uofu-emb-26/Project_SecurityCamera/docs/img/system_overview.png

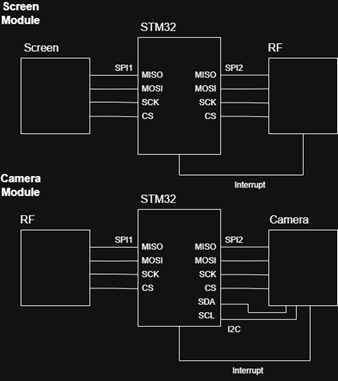
docs/img/system_overview.png
