uofu-emb-26/Project_SecurityCamera/RF/coin.jpeg

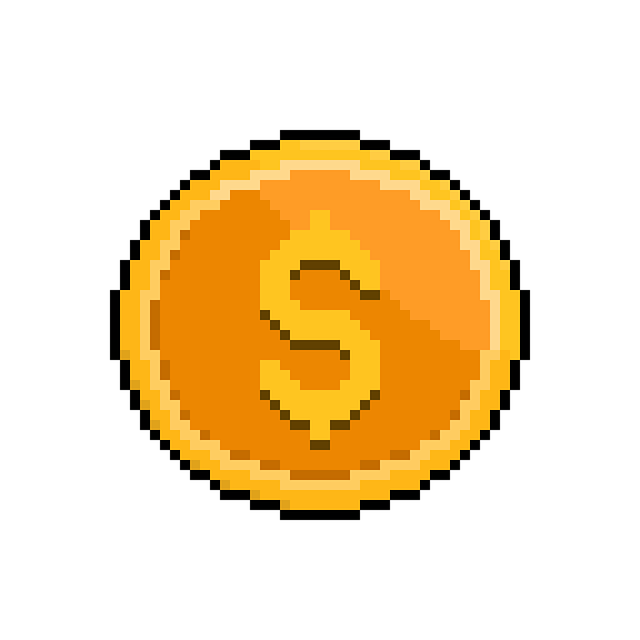
RF/coin.jpeg
