uofu-emb-26/Project_SecurityCamera/camera_screen/captured_frame.h

#ifndef CAPTURED_FRAME_H
#define CAPTURED_FRAME_H

const unsigned int captured_frame_len = 2981;
const unsigned char captured_frame[] = {
    0xFF, 0xD8, 0xFF, 0xE1, 0x01, 0x22, 0x45, 0x78, 0x69, 0x66, 0x00, 0x00, 
    0x49, 0x49, 0x2A, 0x00, 0x08, 0x00, 0x00, 0x00, 0x07, 0x00, 0x0F, 0x01, 
    0x02, 0x00, 0x09, 0x00, 0x00, 0x00, 0x62, 0x00, 0x00, 0x00, 0x10, 0x01, 
    0x02, 0x00, 0x09, 0x00, 0x00, 0x00, 0x6B, 0x00, 0x00, 0x00, 0x1A, 0x01, 
    0x05, 0x00, 0x01, 0x00, 0x00, 0x00, 0x74, 0x00, 0x00, 0x00, 0x1B, 0x01, 
    0x05, 0x00, 0x01, 0x00, 0x00, 0x00, 0x7C, 0x00, 0x00, 0x00, 0x28, 0x01, 
    0x03, 0x00, 0x01, 0x00, 0x00, 0x00, 0x02, 0x00, 0x00, 0x00, 0x13, 0x02, 
    0x03, 0x00, 0x01, 0x00, 0x00, 0x00, 0x02, 0x00, 0x00, 0x00, 0x69, 0x87, 
    0x04, 0x00, 0x01, 0x00, 0x00, 0x00, 0x84, 0x00, 0x00, 0x00, 0x00, 0x00, 
    0x00, 0x00, 0x00, 0x00, 0x00, 0x00, 0x00, 0x00, 0x00, 0x00, 0x00, 0x00, 
    0x00, 0x00, 0x00, 0x00, 0x00, 0x00, 0x00, 0x00, 0x20, 0x01, 0x00, 0x00, 
    0x01, 0x00, 0x00, 0x00, 0x20, 0x01, 0x00, 0x00, 0x01, 0x00, 0x00, 0x00, 
    0x0A, 0x00, 0x9A, 0x82, 0x05, 0x00, 0x01, 0x00, 0x00, 0x00, 0x02, 0x01, 
    0x00, 0x00, 0x27, 0x88, 0x03, 0x00, 0x01, 0x00, 0x00, 0x00, 0x00, 0x00, 
    0x00, 0x00, 0x00, 0x90, 0x07, 0x00, 0x04, 0x00, 0x00, 0x00, 0x30, 0x32, 
    0x32, 0x32, 0x01, 0x91, 0x07, 0x00, 0x04, 0x00, 0x00, 0x00, 0x01, 0x02, 
    0x03, 0x00, 0x01, 0x92, 0x0A, 0x00, 0x01, 0x00, 0x00, 0x00, 0x0A, 0x01, 
    0x00, 0x00, 0x02, 0x92, 0x05, 0x00, 0x01, 0x00, 0x00, 0x00, 0x12, 0x01, 
    0x00, 0x00, 0x00, 0xA0, 0x07, 0x00, 0x04, 0x00, 0x00, 0x00, 0x00, 0x00, 
    0x00, 0x00, 0x01, 0xA0, 0x03, 0x00, 0x01, 0x00, 0x00, 0x00, 0x01, 0x00, 
    0x00, 0x00, 0x02, 0xA0, 0x04, 0x00, 0x01, 0x00, 0x00, 0x00, 0xA0, 0x00, 
    0x00, 0x00, 0x03, 0xA0, 0x04, 0x00, 0x01, 0x00, 0x00, 0x00, 0x78, 0x00, 
    0x00, 0x00, 0x00, 0x00, 0x00, 0x00, 0x01, 0x00, 0x00, 0x00, 0x0F, 0x00, 
    0x00, 0x00, 0x04, 0x00, 0x00, 0x00, 0x01, 0x00, 0x00, 0x00, 0x00, 0x00, 
    0x00, 0x00, 0x00, 0x00, 0x00, 0x00, 0xFF, 0xDB, 0x00, 0x84, 0x00, 0x10, 
    0x0B, 0x0C, 0x0E, 0x0C, 0x0A, 0x10, 0x0E, 0x0D, 0x0E, 0x11, 0x10, 0x10, 
    0x12, 0x17, 0x27, 0x19, 0x17, 0x15, 0x15, 0x17, 0x30, 0x22, 0x24, 0x1C, 
    0x27, 0x39, 0x32, 0x3C, 0x3B, 0x38, 0x32, 0x37, 0x36, 0x3F, 0x47, 0x5A, 
    0x4D, 0x3F, 0x43, 0x55, 0x44, 0x36, 0x37, 0x4F, 0x6B, 0x4F, 0x55, 0x5D, 
    0x60, 0x65, 0x66, 0x65, 0x3D, 0x4C, 0x6F, 0x77, 0x6E, 0x62, 0x76, 0x5A, 
    0x63, 0x65, 0x61, 0x01, 0x10, 0x11, 0x11, 0x17, 0x14, 0x17, 0x2E, 0x19, 
    0x19, 0x2E, 0x61, 0x41, 0x37, 0x41, 0x61, 0x61, 0x61, 0x61, 0x61, 0x61, 
    0x61, 0x61, 0x61, 0x61, 0x61, 0x61, 0x61, 0x61, 0x61, 0x61, 0x61, 0x61, 
    0x61, 0x61, 0x61, 0x61, 0x61, 0x61, 0x61, 0x61, 0x61, 0x61, 0x61, 0x61, 
    0x61, 0x61, 0x61, 0x61, 0x61, 0x61, 0x61, 0x61, 0x61, 0x61, 0x61, 0x61, 
    0x61, 0x61, 0x61, 0x61, 0x61, 0x61, 0x61, 0x61, 0xFF, 0xDD, 0x00, 0x04, 
    0x00, 0xC8, 0xFF, 0xC0, 0x00, 0x11, 0x08, 0x00, 0x78, 0x00, 0xA0, 0x03, 
    0x01, 0x21, 0x00, 0x02, 0x11, 0x01, 0x03, 0x11, 0x01, 0xFF, 0xC4, 0x01, 
    0xA2, 0x00, 0x00, 0x01, 0x05, 0x01, 0x01, 0x01, 0x01, 0x01, 0x01, 0x00, 
    0x00, 0x00, 0x00, 0x00, 0x00, 0x00, 0x00, 0x01, 0x02, 0x03, 0x04, 0x05, 
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
};

#endif
