uofu-emb-26/Project_SecurityCamera/main_base_station/Src/ili9341_font.c

// MIT License
//
// Copyright (c) 2020 ardnew
//
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
// Source: https://github.com/ardnew/ILI9341-STM32-HAL/tree/master

// ----------------------------------------------------------------- includes --

#include "ili9341_font.h"

// ---------------------------------------------------------- private defines --

#define __ILI9341_FONT_FIRST_GLYPH__ ' ' // ASCII 0x20 space
#define __ILI9341_FONT_LAST_GLYPH__  '~' // ASCII 0x7E tilde

// ----------------------------------------------------------- private macros --

/* nothing */

// ----------------------------------------------------------- private types --

/* nothing */

// ------------------------------------------------------- exported variables --

ili9341_font_t const ili9341_font_7x10 = {
  .width  = 7,
  .height = 10,
  .glyph  = {
    0x0000, 0x0000, 0x0000, 0x0000, 0x0000, 0x0000, 0x0000, 0x0000, 0x0000, 0x0000,  // sp
    0x1000, 0x1000, 0x1000, 0x1000, 0x1000, 0x1000, 0x0000, 0x1000, 0x0000, 0x0000,  // !
    0x2800, 0x2800, 0x2800, 0x0000, 0x0000, 0x0000, 0x0000, 0x0000, 0x0000, 0x0000,  // "
    0x2400, 0x2400, 0x7C00, 0x2400, 0x4800, 0x7C00, 0x4800, 0x4800, 0x0000, 0x0000,  // #
    0x3800, 0x5400, 0x5000, 0x3800, 0x1400, 0x5400, 0x5400, 0x3800, 0x1000, 0x0000,  // $
    0x2000, 0x5400, 0x5800, 0x3000, 0x2800, 0x5400, 0x1400, 0x0800, 0x0000, 0x0000,  // %
    0x1000, 0x2800, 0x2800, 0x1000, 0x3400, 0x4800, 0x4800, 0x3400, 0x0000, 0x0000,  // &
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
  }
};

// ------------------------------------------------------- private variables --

/* nothing */

// ------------------------------------------------------ function prototypes --

/* nothing */

// ------------------------------------------------------- exported functions --

uint8_t glyph_index(unsigned char glyph)
{
  if ((glyph >= __ILI9341_FONT_FIRST_GLYPH__) &&
      (glyph <= __ILI9341_FONT_LAST_GLYPH__)) {
    return glyph - __ILI9341_FONT_FIRST_GLYPH__;
  }
  return 0; // on error, return index of ASCII space (0x20)
}

// ------------------------------------------------------- private functions --

/* nothing */
