uofu-emb-26/Project_SecurityCamera/main_base_station/Src/images.c

#include "images.h"

// RGB565 has form RRRR:RGGG_GGGB:BBBB
// This array has been endian swapped to GGGB:BBBB_RRRR:RGGG
// for transmission to the screen (since the STM32F072 is little-endian and the screen is big-endian)
const uint16_t red_16x16[256] = {
    0x00F8, 0x00F8, 0x00F8, 0x00F8, 0x00F8, 0x00F8, 0x00F8, 0x00F8, 0x00F8, 0x00F8, 0x00F8, 0x00F8, 0x00F8, 0x00F8, 0x00F8, 0x00F8,
    0x00F8, 0x00F8, 0x00F8, 0x00F8, 0x00F8, 0x00F8, 0x00F8, 0x00F8, 0x00F8, 0x00F8, 0x00F8, 0x00F8, 0x00F8, 0x00F8, 0x00F8, 0x00F8,
    0x00F8, 0x00F8, 0x00F8, 0x00F8, 0x00F8, 0x00F8, 0x00F8, 0x00F8, 0x00F8, 0x00F8, 0x00F8, 0x00F8, 0x00F8, 0x00F8, 0x00F8, 0x00F8,
    0x00F8, 0x00F8, 0x00F8, 0x00F8, 0x00F8, 0x00F8, 0x00F8, 0x00F8, 0x00F8, 0x00F8, 0x00F8, 0x00F8, 0x00F8, 0x00F8, 0x00F8, 0x00F8,
    0x00F8, 0x00F8, 0x00F8, 0x00F8, 0x00F8, 0x00F8, 0x00F8, 0x00F8, 0x00F8, 0x00F8, 0x00F8, 0x00F8, 0x00F8, 0x00F8, 0x00F8, 0x00F8,
    0x00F8, 0x00F8, 0x00F8, 0x00F8, 0x00F8, 0x00F8, 0x00F8, 0x00F8, 0x00F8, 0x00F8, 0x00F8, 0x00F8, 0x00F8, 0x00F8, 0x00F8, 0x00F8,
    0x00F8, 0x00F8, 0x00F8, 0x00F8, 0x00F8, 0x00F8, 0x00F8, 0x00F8, 0x00F8, 0x00F8, 0x00F8, 0x00F8, 0x00F8, 0x00F8, 0x00F8, 0x00F8,
    0x00F8, 0x00F8, 0x00F8, 0x00F8, 0x00F8, 0x00F8, 0x00F8, 0x00F8, 0x00F8, 0x00F8, 0x00F8, 0x00F8, 0x00F8, 0x00F8, 0x00F8, 0x00F8,
    0x00F8, 0x00F8, 0x00F8, 0x00F8, 0x00F8, 0x00F8, 0x00F8, 0x00F8, 0x00F8, 0x00F8, 0x00F8, 0x00F8, 0x00F8, 0x00F8, 0x00F8, 0x00F8,
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
	0xA7, 0x7A, 0x45, 0x6A, 0xA9, 0xA3, 0x46, 0x6A, 0xA7, 0x72, 0xCA, 0xAB,
	0x89, 0xA3, 0x89, 0x9B, 0x49, 0x93, 0xA7, 0x7A, 0x45, 0x6A, 0xCA, 0xAB,
	0xC7, 0x7A, 0x05, 0x5A, 0xA7, 0x72, 0x46, 0x6A, 0xCA, 0xAB, 0xEA, 0xAB,
	0xE8, 0x82, 0x28, 0x8B, 0xC7, 0x7A, 0xE7, 0x82, 0x48, 0x93, 0x48, 0x93,
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
};

/**
 * @brief Performs an in-place 2-byte endian swap on an array of 16-bit pixel data.
 * @note For this function to work, buffer16 must be stored in RAM (it must not be a const)
 * @param buffer16 Pointer to the 16-bit pixel buffer to be swapped. 
 * @param num_pixels The total number of 16-bit pixels in the buffer.
 */
void ili9341_array_endian_swap(uint16_t *buffer16, uint32_t num_pixels)
{
    uint32_t *buffer32 = (uint32_t *)buffer16;

    // Perform the endian swap on every two pixels
    for (uint32_t i = 0; i < (num_pixels / 2); i++)
    {
        // Flips A, B, C, D to B, A, D, C (endian-swap on 2-byte values)
		// This is a hardware instruction, so this performs the endian-swap
		// as quickly as possible
        buffer32[i] = __REV16(buffer32[i]);
    }

    // Endian-swap on the final pixel, if needed
    if ((num_pixels % 2) != 0)
    {
        buffer16[num_pixels - 1] = __REV16(buffer16[num_pixels - 1]);
    }
}
