uofu-emb-26/Project_SecurityCamera/camera_screen/Src/spi.c

#include "spi.h"
#include "main.h"
#include "stm32f0xx_hal.h"

SPI_HandleTypeDef hspi1;
SPI_HandleTypeDef hspi2;
DMA_HandleTypeDef hdma_spi1_tx;

/* ===================== SPI2 : CAMERA ===================== */

void SPI2_Init(void)
{
    __HAL_RCC_SPI2_CLK_ENABLE();
    __HAL_RCC_GPIOB_CLK_ENABLE();

    GPIO_InitTypeDef GPIO_InitStruct = {0};
    GPIO_InitStruct.Pin = GPIO_PIN_13 | GPIO_PIN_14 | GPIO_PIN_15;
    GPIO_InitStruct.Mode = GPIO_MODE_AF_PP;
    GPIO_InitStruct.Pull = GPIO_NOPULL;
    GPIO_InitStruct.Speed = GPIO_SPEED_FREQ_HIGH;
    GPIO_InitStruct.Alternate = GPIO_AF0_SPI2;
    HAL_GPIO_Init(GPIOB, &GPIO_InitStruct);

    hspi2.Instance = SPI2;
    hspi2.Init.Mode = SPI_MODE_MASTER;
    hspi2.Init.Direction = SPI_DIRECTION_2LINES;
    hspi2.Init.DataSize = SPI_DATASIZE_8BIT;
    hspi2.Init.CLKPolarity = SPI_POLARITY_LOW;
    hspi2.Init.CLKPhase = SPI_PHASE_1EDGE;
    hspi2.Init.NSS = SPI_NSS_SOFT;
    hspi2.Init.BaudRatePrescaler = SPI_BAUDRATEPRESCALER_32;
    hspi2.Init.FirstBit = SPI_FIRSTBIT_MSB;
    hspi2.Init.TIMode = SPI_TIMODE_DISABLE;
    hspi2.Init.CRCCalculation = SPI_CRCCALCULATION_DISABLE;
    hspi2.Init.CRCPolynomial = 7;
    hspi2.Init.CRCLength = SPI_CRC_LENGTH_DATASIZE;
    hspi2.Init.NSSPMode = SPI_NSS_PULSE_ENABLE;

    HAL_SPI_Init(&hspi2);
}

uint8_t SPI2_ReadWriteByte(uint8_t TxData)
{
    uint8_t RxData = 0;
    HAL_SPI_TransmitReceive(&hspi2, &TxData, &RxData, 1, 100);
    return RxData;
}

void SPI2_WriteBuffer(uint8_t *data, uint32_t len)
{
    HAL_SPI_Transmit(&hspi2, data, len, HAL_MAX_DELAY);
}

/* ===================== SPI1 : SCREEN ===================== */

void SPI1_DMA_Init(void)
{
    __HAL_RCC_DMA1_CLK_ENABLE();

    HAL_NVIC_SetPriority(DMA1_Channel2_3_IRQn, 0, 0);
    HAL_NVIC_EnableIRQ(DMA1_Channel2_3_IRQn);
}

void SPI1_GPIO_Init(void)
{
    GPIO_InitTypeDef GPIO_InitStruct = {0};

    __HAL_RCC_GPIOA_CLK_ENABLE();
    __HAL_RCC_GPIOB_CLK_ENABLE();

    /* TFT control pins on GPIOA */
    HAL_GPIO_WritePin(GPIOA, TFT_CS_Pin | TFT_DC_Pin | TFT_RST_Pin, GPIO_PIN_SET);

    GPIO_InitStruct.Pin = TFT_DC_Pin;
    GPIO_InitStruct.Mode = GPIO_MODE_OUTPUT_PP;
    GPIO_InitStruct.Pull = GPIO_NOPULL;
    GPIO_InitStruct.Speed = GPIO_SPEED_FREQ_HIGH;
    HAL_GPIO_Init(TFT_DC_GPIO_Port, &GPIO_InitStruct);

    GPIO_InitStruct.Pin = TFT_CS_Pin;
    GPIO_InitStruct.Mode = GPIO_MODE_OUTPUT_OD;
    GPIO_InitStruct.Pull = GPIO_NOPULL;
    GPIO_InitStruct.Speed = GPIO_SPEED_FREQ_HIGH;
    HAL_GPIO_Init(TFT_CS_GPIO_Port, &GPIO_InitStruct);

    GPIO_InitStruct.Pin = TFT_RST_Pin;
    GPIO_InitStruct.Mode = GPIO_MODE_OUTPUT_OD;
    GPIO_InitStruct.Pull = GPIO_PULLUP;
    GPIO_InitStruct.Speed = GPIO_SPEED_FREQ_LOW;
    HAL_GPIO_Init(TFT_RST_GPIO_Port, &GPIO_InitStruct);

    /* SPI1 pins on GPIOB: PB3=SCK, PB4=MISO, PB5=MOSI */
    GPIO_InitStruct.Pin = GPIO_PIN_3 | GPIO_PIN_4 | GPIO_PIN_5;
    GPIO_InitStruct.Mode = GPIO_MODE_AF_PP;
    GPIO_InitStruct.Pull = GPIO_NOPULL;
    GPIO_InitStruct.Speed = GPIO_SPEED_FREQ_HIGH;
    GPIO_InitStruct.Alternate = GPIO_AF0_SPI1;
    HAL_GPIO_Init(GPIOB, &GPIO_InitStruct);
}

void SPI1_Init(void)
{
    __HAL_RCC_SPI1_CLK_ENABLE();

    hspi1.Instance = SPI1;
    hspi1.Init.Mode = SPI_MODE_MASTER;
    hspi1.Init.Direction = SPI_DIRECTION_2LINES;
    hspi1.Init.DataSize = SPI_DATASIZE_8BIT;
    hspi1.Init.CLKPolarity = SPI_POLARITY_LOW;
    hspi1.Init.CLKPhase = SPI_PHASE_1EDGE;
    hspi1.Init.NSS = SPI_NSS_SOFT;
    hspi1.Init.BaudRatePrescaler = SPI_BAUDRATEPRESCALER_4;
    hspi1.Init.FirstBit = SPI_FIRSTBIT_MSB;
    hspi1.Init.TIMode = SPI_TIMODE_DISABLE;
    hspi1.Init.CRCCalculation = SPI_CRCCALCULATION_DISABLE;
    hspi1.Init.CRCPolynomial = 7;
    hspi1.Init.CRCLength = SPI_CRC_LENGTH_DATASIZE;
    hspi1.Init.NSSPMode = SPI_NSS_PULSE_ENABLE;

    HAL_SPI_Init(&hspi1);
}

void SPI1_WriteBuffer(uint8_t *data, uint32_t len)
{
    HAL_SPI_Transmit(&hspi1, data, len, HAL_MAX_DELAY);
}
