uofu-emb-26/Project_SecurityCamera/main_base_station/Inc/ili9341_ext.h

// Created by Zachary Ward to extend the ILI9341 TFT driver to write raw buffer
// data using DMA.

#ifndef __ILI9341_EXT_H
#define __ILI9341_EXT_H

#include <stdint.h>
#include "ili9341.h"
#include "ili9341_gfx.h"
#include "images.h"

// The display uses RGB565 (with 16 color bits per pixel)
#define BYTES_PER_PIXEL 2

#ifdef __cplusplus
extern "C" {
#endif

void ili9341_draw_buffer(ili9341_t *lcd, int16_t x, int16_t y, int16_t w, int16_t h, uint16_t *buffer, uint8_t endian_swap);
void ili9341_draw_region(ili9341_t *lcd, uint8_t column, uint8_t row, uint16_t *buffer, uint8_t endian_swap);

#ifdef __cplusplus
}
#endif

#endif /* __ILI9341_EXT_H */
