uofu-emb-26/Project_SecurityCamera/(commit log)

2026-03-17 Restructure repo into separate folders, removed labs from CMAKE and added new folders, add ArduCAM HAL driver files.
2026-03-21 Extended ILI9341 library to draw a buffer to the screen using DMA
2026-03-21 Initialized SPI, DMA, and GPIO peripherals (code autogenerated by STM32CubeMx)
2026-03-21 Added camera.c, and camera.h. Split the debug and main into two builds. Functionality for reading JPEG data using I2C/SPI.
2026-03-21 Added notes on which pins can be used for SPI and I2C
2026-03-21 Updated display connections to those usable on the Discovery board
2026-03-21 Fixed ILI9341 library for when no touchscreen is connected
    [ili9341.c]
2026-03-22 Fixed type sizes in ILI9341 library
    [ili9341_gfx.c, ili9341_gfx.h]
2026-03-22 Added wiring diagram for screen
2026-03-26 add nrf24l01p driver and verify spi communication
2026-04-01 Add NRF24L01+ SPI loopback test with LED status indicators
2026-04-01 Added python script in camera folder.
2026-04-08 Added functionality for SPI read out of JPEG data. Adder timer/interupt functionality to camera/main. Added ability to individual camera data using camera/main_uart_debug.
2026-04-15 Created project for the Camera Module; merged code for camera and RF chips (moved RF TX to SPI1)
2026-04-16 Added Camera Module code to synchronize frame capture with RF transmission
2026-04-16 fixed wrong named variables
    [main.c]
2026-04-16 Add TX/RX image transmission code by using two STM boards
2026-04-16 Added camera_screen files to flash camera data on screen.
2026-04-16 Added working camera/TJpegDec decoder code
2026-04-16 made 'rect' a member of JDEC structure as a global variable and inserted wait statement for SPI
2026-04-16 Notes on needed pin remappings (final pin layout)
2026-04-19 Integrated RF+Camera projects for main_camera_module and RF+camera_screen projects for main_base_station; added sychronization and buffers for each
2026-04-19 Added RF transmit failure logic and LED error indicators
    [jpeg_decode.c, main.c, main.h]
2026-04-19 Fixed interrupt priorities
2026-04-19 Remapped pins in both main modules to prevent conflicts on the STM32F072 Discovery Board
    [main.c]
2026-04-19 Fixed Base Station RF pins
    [main.c]
2026-04-21 Troubleshooting communication with camera
2026-04-22 (working) Replaced camera with static image; converted all interrupts to polling; converted DMA to blocking
    [main.c, test_frame.h]
2026-04-22 (working) Reverted Base Station code to fancy version
    [main.c]
2026-04-22 (working) Replaced Camera Module with fancy version (without camera)
    [main.c]
2026-04-22 (working) reverted pins to system diagram
    [ArduCAM.c, ArduCAM.h, main.c]
2026-04-22 Remove USB-UART Bridge details from README
    Removed RX STM32 ↔ USB-UART Bridge section from README.
2026-04-24 Added final wiring diagram
2026-04-24 Added data flow documentation
2026-04-28 Added camera description to README. Added camera and base station images to overview in README.
