uofu-emb-26/Project_SecurityCamera/docs/img/system_connections.png

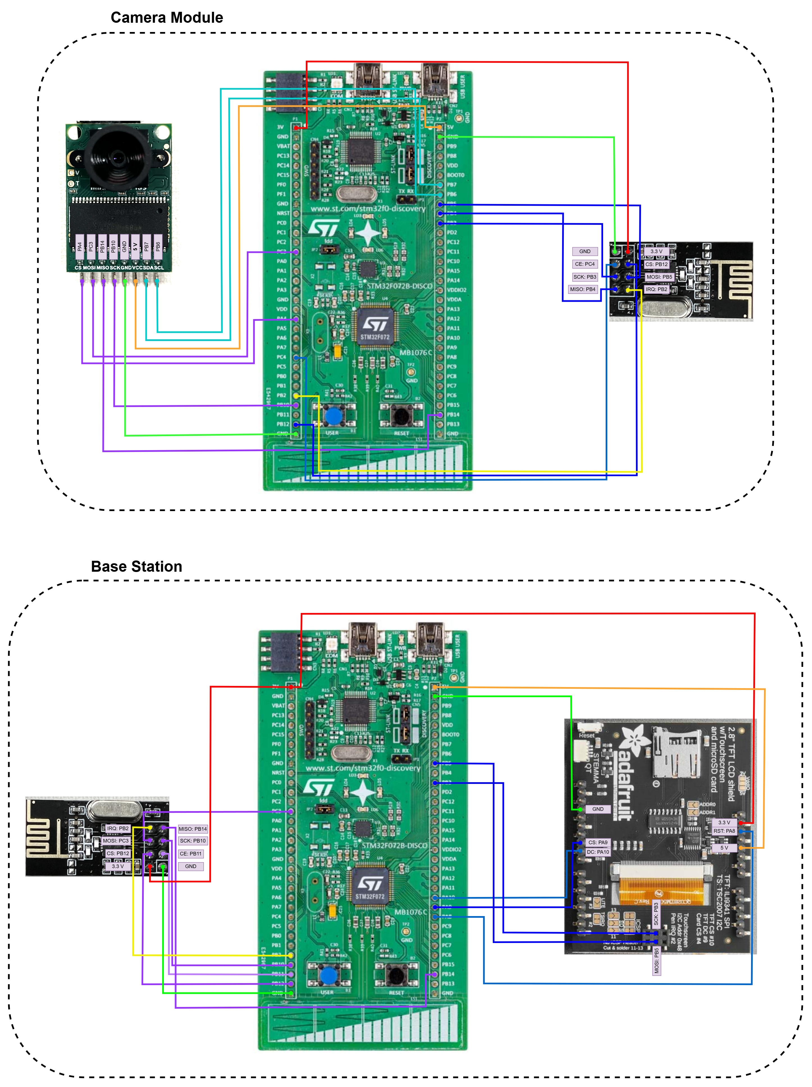
[picture p2: docs/img/system_connections.png]
docs/img/system_connections.png
